fichetto/jetson-autonomous-rover/checkerboard_10x7.png

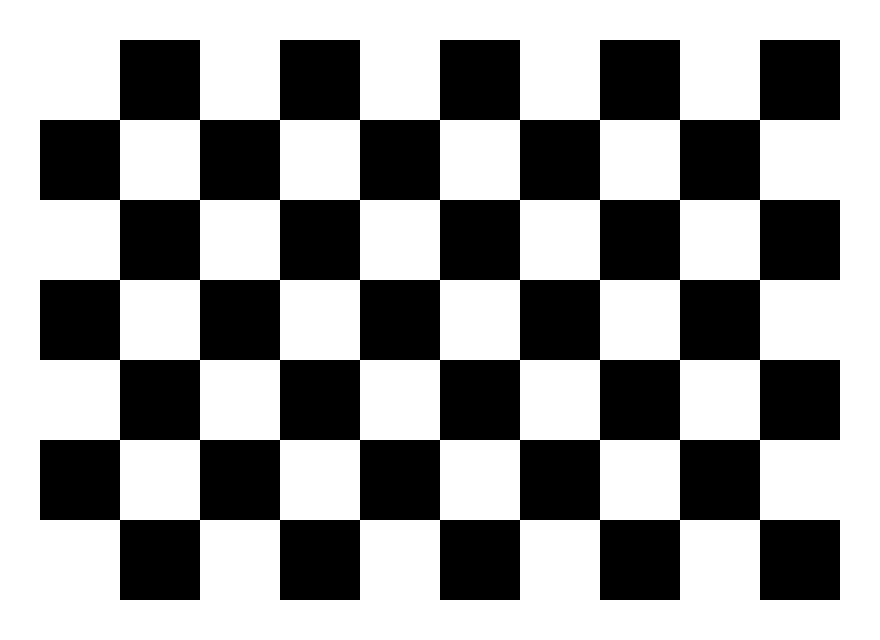
checkerboard_10x7.png
