fichetto/jetson-autonomous-rover/(commit log)

2025-12-24 Initial commit: Autonomous Rover project for Jetson Orin Nano
    Complete autonomous rover system with:
    - Mechanum wheels control system
    - 6 ultrasonic sensors with sensor fusion
    - Modbus RTU communication with Arduino
    - Vision system with CUDA/TensorRT acceleration
    - Object detection and obstacle avoidance
    - Path planning algorithms
    - Docker containerization support
    - Hardware diagnostic test suite
    Hardware tested and verified operational after power incident.
    [camera.py, detector.py, mechanum_drive.py, modbus_client.py, rover_config.yaml, test_hardware.py]
2025-12-28 refactor: Update project to CLOVER specifications
    Hardware specifications updated:
    - Motor driver: Moebius Shield + PCA9685 (I2C) + HR8833
    - Motors: JGB 520 (12V DC, 330 RPM, Hall encoder)
    - Battery: LiPo 3S2P (11.1V nominal, 9.0-12.6V range)
    - Chassis: 300 x 250 mm
    Software changes:
    - Renamed project from autonomous-rover to CLOVER
    - Updated modbus_client.py with CloverModbusClient class
    - Added encoder reading and battery voltage monitoring
    - Updated mechanum_drive.py with JGB520 motor specs
    - Added encoder-to-velocity conversion
    - Updated register map for motor control and sensors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
2025-12-29 feat: Add Arduino firmware for Moebius motor driver
    New firmware in firmware/clover_arduino/:
    - clover_arduino.ino: Main sketch with Modbus RTU slave
    - config.h: Pin mapping and Modbus register definitions
    - motor_driver.h: PCA9685 + HR8833 motor control
    - encoder.h: Hall encoder reading (interrupt + polling)
    - battery.h: LiPo 3S2P voltage monitoring
    Features:
    - 4-channel DC motor control via I2C (PCA9685)
    - Hall encoder feedback for all 4 motors
    - Battery voltage monitoring with low-voltage protection
    - Modbus RTU communication (115200 baud, ID 1)
    - Safety watchdog (2s timeout)
    - Emergency stop support
    Hardware support:
    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
2025-12-31 feat: Add VR teleoperation system for Meta Quest 3
    New features:
    - Stereo camera capture with dual IMX219 (CSI)
    - MJPEG streaming server with web interface
    - WebSocket control server for joystick input
    - Web-based teleop UI with keyboard/touch controls
    - Unity Quest 3 app scaffolding (WebRTC + controllers)
    Components added:
    - src/teleop/ - Streaming and control servers
    - src/vision/stereo_camera.py - Frame distribution system
    - unity/CloverVR/ - Meta Quest 3 Unity project
    - tools/view_stream.py - PC video viewer
    - start_teleop.py - Quick start script
    Web interface features:
    - Live stereo video stream
    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
2026-01-02 feat: Add unified RoverService architecture and Telegram bot
    New unified architecture with centralized Arduino connection:
    - RoverService (port 8082): Central motor control service
    - Single Modbus connection shared by all clients
    - HTTP API for control commands
    - WebSocket for real-time teleoperation
    - Watchdog timeout for safety
    - Priority arbitration (e-stop > autonomous > teleop > manual)
    - Telegram Bot: Remote control and monitoring
    - Commands: /start, /status, /connect, /manual, /auto, /stop, /estop
    - Inline keyboard for movement control
    - Real-time status updates
    - MJPEG Server (port 8090): Stereo camera streaming
    - Updated to use RoverService WebSocket on port 8082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
2026-01-02 docs: Add CLOVER rover photo to README
    Added photo showing the complete rover setup:
    - Jetson Orin Nano with cooling fan
    - 2x IMX219 stereo cameras
    - 4x Mecanum wheels
    - Arduino with Moebius motor shield
    - LiPo battery
    - Custom aluminum/acrylic chassis
2026-01-03 docs: Add Moebius Shield power wiring documentation
    CRITICAL safety documentation added after hardware incident:
    - Document two separate power terminals (Supply Power vs Servo Power)
    - Explain jumper 5V-VCC50-VM function for servo power selection
    - Add warning: NEVER connect 11.1V battery to Servo Power terminal
    - Explain failure mode that can damage Arduino and USB host ports
    Lesson learned: Wrong power connection fried Arduino Uno and two
    Jetson Orin Nano USB ports.
2026-01-03 feat: Update firmware and tests for improved motor control and Modbus integration
    - Updated clover_arduino.ino to version 1.1 with enhancements in Modbus RTU communication and motor control logic.
    - Modified config.h for corrected PCA9685 channel mapping and voltage divider calibration.
    - Enhanced modbus_client.py to align with Arduino firmware changes and added compatibility checks.
    - Added I2C scanner and PCA9685 test sketches for device detection and motor functionality testing.
    - Implemented test sketches for Moebius motors and motor direction verification.
    - Improved test_modbus and test_modbus2 for better Modbus RTU testing with the new library.
    - Added comprehensive comments and docum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
    [clover_arduino.ino, config.h, i2c_scan.ino, modbus_client.py, test_channels.ino, test_modbus.ino, test_modbus2.ino, test_moebius.ino]
2026-02-01 feat: Fix Modbus motor control and add calibration tools
    - Fix watchdog race condition causing motors to stop immediately
    (unsigned underflow when using stale currentMillis vs fresh callback update)
    - Implement direct PWM control in Modbus callback (pattern from working datalogger)
    - Add local register storage for motor speeds (onSetHreg/onGetHreg callbacks)
    - Calibrate battery voltage divider ratio (7.15 for accurate 12.6V reading)
    - Add PWM offset/scale calibration support in motor_driver.h
    - Add PID controller header for future closed-loop control
    - Add interactive calibration script (calibrate_interactive.py)
    - Add test scripts for motor control and Modbus debugging
    - Update test_pca96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
    [calibrate_interactive.py, calibrate_motors.py, calibrate_pwm_offsets.py, clover_arduino.ino, config.h, motor_driver.h, pid_controller.h, test_modbus_motor.ino]
2026-02-01 feat: Add cat follower with stereo depth estimation
    - Add stereo_depth.py: StereoSGBM depth estimation from stereo camera pair
    - Add cat_follower.py: Complete cat following system with:
    - YOLOv8n cat detection (COCO class 15)
    - Stereo depth measurement for distance estimation
    - PID-like control to maintain 50cm following distance
    - Modbus motor control integration
    - Update vision __init__.py with new exports
    Note: YOLOv8n model must be downloaded separately (not in git):
    python3 -c "from ultralytics import YOLO; YOLO('yolov8n.pt')"
2026-02-02 fix: Correct L/R wheel channel mapping
    - Swap FL<->FR and RL<->RR channel assignments in config.h
    - Update onMotorWrite callback to use config arrays instead of hardcoded channels
    - Update watchdog to use same channel mapping arrays
    - Adjust motor inversion flags for swapped physical connections
    Tested: All 4 wheels now respond to correct motor index (1=FL, 2=FR, 3=RL, 4=RR)
    [clover_arduino.ino, config.h]
2026-02-02 feat: Add stereo calibration tools and improve system stability
    - Add stereo calibration scripts (GUI, headless, lite versions)
    - Add stop_camera_services.sh to free cameras for calibration
    - Reduce mjpeg_server default resolution to 640x480@15fps
    - Defer YOLO model loading until explicitly requested
    - Add checkerboard image for calibration
    [calibrate_stereo.py, calibrate_stereo_headless.py, calibrate_stereo_lite.py]
2026-02-02 feat: Add test scripts and workspace documentation
    - Add WORKSPACE_INVENTORY.md with system architecture docs
    - Add cat_tracker.py and cat_detection_overlay.py scripts
    - Add simple_camera_test.py and test_stereo_detection.py
    - Minor fixes to mechanum_drive.py and cat_follower.py
    [cat_detection_overlay.py, cat_follower.py, cat_tracker.py, mechanum_drive.py, simple_camera_test.py, test_stereo_detection.py]
2026-02-03 fix: Swap L/R camera sensor IDs (cameras mounted upside-down)
    Cameras are physically mounted upside-down and rotated 180°.
    This swaps sensor IDs so left/right are correct:
    - Left camera: sensor_id=1
    - Right camera: sensor_id=0
    [calibrate_stereo.py, calibrate_stereo_headless.py, calibrate_stereo_lite.py, stereo_camera.py]
2026-02-03 feat: Add stereo camera calibration (baseline 8.01cm, focal 796.7px)
    - Add stereo_calibration.npz with rectification maps
    - Add 10x7 checkerboard pattern for calibration
    - Add debug script for checkerboard detection
2026-02-03 feat: Integrate real stereo calibration and add obstacle avoidance
    stereo_depth.py:
    - Add StereoCalibration.load_from_file() to load from .npz
    - Add rectification support using calibration maps
    - Use real calibration values (baseline=8.01cm, focal=796.7px)
    cat_follower.py:
    - Load real calibration instead of hardcoded values
    - Add obstacle avoidance with configurable thresholds
    - Slowdown when obstacles detected (40cm stop, 60cm slowdown)
    - Visual warning overlay for obstacle detection
    [cat_follower.py, stereo_depth.py]
2026-02-03 feat: Add cat follower integration test
    Tests all components together:
    - Stereo calibration loading
    - Depth estimation with rectification
    - Obstacle detection zones
2026-02-03 fix: Correct camera sensor IDs and add 180° flip for cat_follower
    [cat_follower.py]
2026-02-03 feat: Add high-level motor API and counter-rotation patrol
    ## Changes Made
    ### 1. High-Level Motor Commands (modbus_motors.py - NEW FILE)
    Thread-based Modbus controller with percentage-based API:
    - `motors.stop()` - Stop all motors
    - `motors.forward(50)` - Forward at 50%
    - `motors.backward(30)` - Backward at 30%
    - `motors.rotate_right(40)` - Rotate right at 40%
    - `motors.rotate_left(40)` - Rotate left at 40%
    - `motors.drive(fwd, rot)` - Combined command (-100 to +100%)
    - 20Hz command rate in background thread
    - Watchdog stops motors after 0.5s without commands
    - Automatic reconnection on errors
    ### 2. Cat Follower Improvements (cat_follower.py)
    - Counter-rotation patrol: alterna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
    [cat_follower.py, modbus_motors.py, test_clahe_detection.py]
